rothn/compact-hd-dac/dac_board/part_libraries/DCK0006A.stp

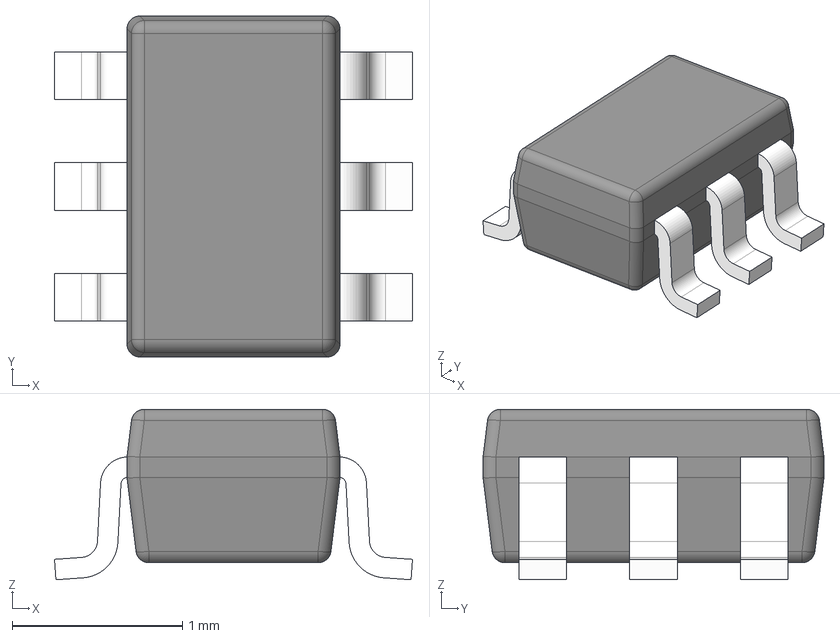
[picture p1: CAD file, 2026-02-09]
dac_board/part_libraries/DCK0006A.stp
2.10 x 2.00 x 1.00 mm
BODY-SOT
LEAD-SOT x 6
PIN1-ID
