rothn/compact-hd-dac/dac_board/part_libraries/Molex_1054440011/1054440011.STEP

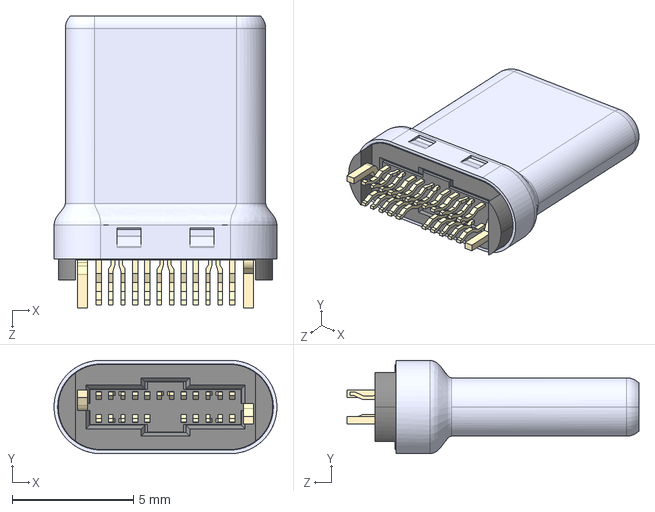
[picture p2: CAD file, 2026-02-22]
dac_board/part_libraries/Molex_1054440011/1054440011.STEP
9.18 x 3.84 x 12.0 mm
