rothn/compact-hd-dac/compact_audio_dac_amp_output_stage_unipolar.asc

C1: cap; 510p; V=50 Irms=0 Rser=0 Lser=0 mfg="Murata" pn="GCM1555C1H511JA16" type="C0G"
C2: cap; 510p; V=50 Irms=0 Rser=0 Lser=0 mfg="Murata" pn="GCM1555C1H511JA16" type="C0G"
C3: cap; 10p; V=50 Irms=0 Rser=0 Lser=0 mfg="Murata" pn="GCM0335C1H100JA16" type="C0G"
C4: cap; 0.0022µ; V=50 Irms=0 Rser=0 Lser=0 mfg="Murata" pn="GCM1885C1H222JA16" type="C0G"
C5: cap; 0.0022µ; V=50 Irms=0 Rser=0 Lser=0 mfg="Murata" pn="GCM1885C1H222JA16" type="C0G"
C6: cap; 0.47µ; V=50 Irms=0 Rser=0 Lser=0 mfg="Murata" pn="GCM21BR71H474KA55" type="X7R"
C7: cap; 0.47µ; V=50 Irms=0 Rser=0 Lser=0 mfg="Murata" pn="GCM21BR71H474KA55" type="X7R"
C8: cap; 10p; V=50 Irms=0 Rser=0 Lser=0 mfg="Murata" pn="GCM0335C1H100JA16" type="C0G"
C9: cap; 0.1µ; V=50 Irms=0 Rser=0 Lser=0 mfg="Murata" pn="GCM21BR71H474KA55" type="X7R"
C10: cap; 0.1µ; V=25 Irms=0 Rser=0 Lser=0 mfg="Murata" pn="GCM155R71E104KE02" type="X7R"
C11: cap; 10µ
I1: current; SINE(0 0.0013 100)
I2: current; SINE(0 -0.0013 100)
R1: res; 3600
R2: res; 3600
R3: res; 3600
R4: res; 3600
R5: res; 4700
R6: res; 4700
R7: res; 140
R8: res; 140
R9: res; 1
R10: res; 500
R11: res; 500
R12: res; 500
R13: res; 100k
R14: res; 500
R15: res; 500
R16: res; 500
R17: res; 100k
R18: res; 3
R19: res; 3
R20: res; 32
R21: res; 1
U1: opamp2; OPA161x
U2: opamp2; OPA161x
U3: opamp2; OPA1656
U5: opamp2; OPA1656
V1: voltage; 17.5
V2: voltage; -17.5
Named nets: 0, DAC, DACb, preamp_OUTb, preamp_OUT, +18V, -18V, OUT
.ac oct 1000 30 2000
.dc V3 0.2 3.1 0.01
.lib C:\\Users\
roth\\Documents\\LTspice\\lib\\sub\\OPA161x.LIB
TODO: Adjust
OPA1612
OPA1612
.lib C:\\Users\
roth\\Documents\\LTspice\\lib\\sub\\OPA1656.LIB
Load
.tran 0 1s 0 0.01u
TODO: Adjust
0.0005A for 4V p-p @ 1kHz ; 1.8W
0.0013A for 10V p-p @ 1kHz ; 3.8W
(clips any higher-- may need more parallel output stages)
0.0005A for 4V p-p @ 100Hz ; 1.8W
0.0013A for 10V p-p @ 100Hz ; 3.8W
