rothn/compact-hd-dac/opamp_power_supply_5071.asc

C1: cap; 1µ
C8: cap; 10µ
C9: cap; 1µ
C10: cap; 10µ
C11: cap; 2n
C12: cap; 10µ
C13: cap; 1µ
C14: cap; 1n
D1: schottky
D2: schottky
L1: ind; 6.8µ; Ipk=3.7 Rser=43.5m
L2a: ind; 4.7µ
L2b: ind; 4.7µ
R7: res; 120k
R8: res; 2.5Meg
R9: res; 20k
R10: res; 130k
R11: res; 3Meg
R12: res; 43k
Rload3: res; 75
Rload4: res; 75
U1: ADP5071
V2: VOLTAGE; 20
Named nets: 0, IN, OUT1, OUT2
.tran 0 5m 0 startup
.MODEL DI_DFLS240L D  ( IS=516n RS=31.4m BV=40.0 IBV=500u
+ CJO=292p  M=0.333 N=0.911 TT=7.20n )
DFLS240
GRM32ER71H106KA12L
DFLS240
GRM32ER71H106KA12L
.savebias 5071_stable.op time=5m
.loadbias 5071_stable.op
XGL4030-682MEC
K1 L2a L2b 0.98
LPD5030-472 ?
150 ohm load for 4W constant output
