rothn/compact-hd-dac/compact_audio_dac_amp_output_stage.asc

C1: cap; 510p; V=50 Irms=0 Rser=0 Lser=0 mfg="Murata" pn="GCM1555C1H511JA16" type="C0G"
C2: cap; 510p; V=50 Irms=0 Rser=0 Lser=0 mfg="Murata" pn="GCM1555C1H511JA16" type="C0G"
C3: cap; 10p; V=50 Irms=0 Rser=0 Lser=0 mfg="Murata" pn="GCM0335C1H100JA16" type="C0G"
C4: cap; 0.0022µ; V=50 Irms=0 Rser=0 Lser=0 mfg="Murata" pn="GCM1885C1H222JA16" type="C0G"
C5: cap; 0.0022µ; V=50 Irms=0 Rser=0 Lser=0 mfg="Murata" pn="GCM1885C1H222JA16" type="C0G"
C6: cap; 0.47µ; V=50 Irms=0 Rser=0 Lser=0 mfg="Murata" pn="GCM21BR71H474KA55" type="X7R"
C7: cap; 0.47µ; V=50 Irms=0 Rser=0 Lser=0 mfg="Murata" pn="GCM21BR71H474KA55" type="X7R"
R1: res; 3600
R2: res; 3600
R3: res; 3600
R4: res; 3600
R5: res; 4700
R6: res; 4700
R7: res; 140
R8: res; 140
R9: res; 100k
U1: opamp2; OPA161x
U2: opamp2; OPA161x
V1: voltage; 18
V2: voltage; -18
V3: voltage; 0.2; AC 2
Named nets: 0, DAC, DACb, OUTb, OUT, +18V, -18V
.ac oct 1000 30 2000
.dc V3 0.2 3.1 0.01
.inc OPA161x.LIB
