rothn/compact-hd-dac/opamp_power_supply.asc

C1: cap; 10µ
C2: cap; 47n
C3: cap; 10µ
C4: cap; 1µ
C5: cap; 1n
C6: cap; 10µ
C7: cap; 1µ
D3: schottky
D4: schottky
L1: ind; 4.7µ; Rser=26m
L2: ind; 4.7µ; Rser=40.1m
R1: res; 2.5Meg
R2: res; 120k
R3: res; 15k
R4: res; 2.67Meg
R5: res; 113k
R6: res; 39k
Rload1: res; 70
Rload2: res; 70
U2: ADP5070
V1: VOLTAGE; 5
Named nets: 0, IN, OUT1, OUT2
.tran 0 10s 0 1m startup
XAL4030-472ME
XAL4030-472ME
DFLS240
DFLS240
GRM32ER71H106KA12L
GRM32ER71H106KA12L
.MODEL DI_DFLS240L D  ( IS=516n RS=31.4m BV=40.0 IBV=500u
+ CJO=292p  M=0.333 N=0.911 TT=7.20n )
