rothn/compact-hd-dac/(commit log)

2025-07-31 Added power supply component calculator
    [psu_calculator.ods]
2025-08-02 Progress commit
    [psu_calculator.ods]
2025-08-03 Switched to coupled inductors for SEPIC
2025-11-03 Finished adding everything with a SPICE simulation
    [amplifier.kicad_sch, dac_board.kicad_sch]
2025-11-16 Additional work on DAC
    [amplifier.kicad_sch, amplifier_power.kicad_sch, dac.kicad_sch, dac_board.kicad_sch]
2025-11-21 More updates, finished DAC block
    [amplifier.kicad_sch, amplifier_power.kicad_sch, dac.kicad_sch, dac_board.kicad_sch]
2025-11-23 Added MCU and associated logic
    [dac.kicad_sch, dac_board.kicad_sch, mcu.kicad_sch]
2025-11-24 Updated schematic with detailed info from SPICE simulations
    [amplifier.kicad_sch, dac_board.kicad_sch, mcu.kicad_sch]
2025-11-24 More SPICE updates
    [dac_board.kicad_sch]
2025-11-30 Power stuff
    [dac_board.kicad_sch]
2026-02-09 Finished schematic design for MCU + DAC
    [DCK0006A.stp, amplifier.kicad_sch, amplifier_power.kicad_sch, dac.kicad_sch, dac_board.kicad_sch, mcu.kicad_sch]
2026-02-22 Updated USB section to include compliant power management
    [1054440011.STEP, 1054440011.step, dac_board.kicad_sch, usb.kicad_sch]
2026-02-23 Wired up USB and USB-PD to MCU
    [dac_board.kicad_sch, mcu.kicad_sch]
2026-02-25 Added power supplies. First complete schematic draft.
    [20v_analog_rail.kicad_sch, 20v_rail_generator.kicad_sch, amplifier_20v_rail_power_management.kicad_sch, dac_board.kicad_sch, low_voltage_power.kicad_sch, mcu.kicad_sch, usb.kicad_sch]
2026-02-25 Added additional details to amplifier schematic
    [amplifier.kicad_sch]
2026-03-08 Added TVS protection, USB CC handling, grounded MCU pins, impedance-matched HF traces, and increased output current capability per consultation with circuit-board-design.com
    [amplifier.kicad_sch, amplifier_output_stage.kicad_sch, dac.kicad_sch, mcu.kicad_sch, usb.kicad_sch]
